CottonEngineering/Cotton/VIPR_PCB/PiHAT_SSR_V4/PiHAT_SSR_V4.brd

## EAGLE design VIPR_PCB/PiHAT_SSR_V4/PiHAT_SSR_V4.brd (2020-04-01)

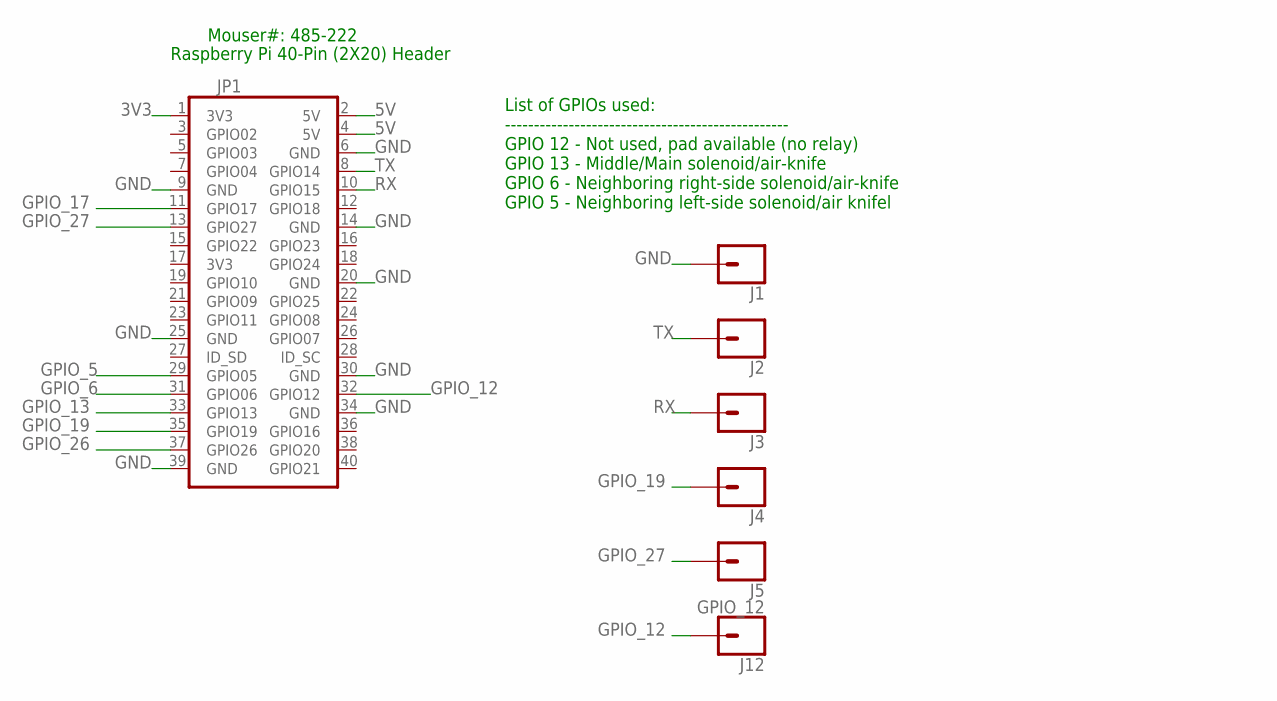
[picture p1: schematic PiHAT_SSR_V4.sch, sheet 1, Raspberry Pi GPIO pin layout schematc]

Parts:
J1, J2, J3, J4, J5: CONN_01; 1X01
J12: GPIO_12; 1X01
JP1: 40W_PI_HAT_TPH; 2X20

Connections:
3V3: JP1.1 (3V3); also elsewhere on the board
5V: JP1.2 (5V), JP1.4 (5V); also elsewhere on the board
GND: J1.1, JP1.6 (GND), JP1.9 (GND), JP1.14 (GND), JP1.20 (GND), JP1.25 (GND), JP1.30 (GND), JP1.34 (GND), JP1.39 (GND); also elsewhere on the board
GPIO_5: JP1.29 (GPIO05); also elsewhere on the board
GPIO_6: JP1.31 (GPIO06); also elsewhere on the board
GPIO_12: J12.1, JP1.32 (GPIO12)
GPIO_13: JP1.33 (GPIO13); also elsewhere on the board
GPIO_17: JP1.11 (GPIO17); also elsewhere on the board
GPIO_19: J4.1, JP1.35 (GPIO19)
GPIO_26: JP1.37 (GPIO26)
GPIO_27: J5.1, JP1.13 (GPIO27)
RX: J3.1, JP1.10 (GPIO15)
TX: J2.1, JP1.8 (GPIO14)

Notes on the sheet:
Raspberry Pi 40-Pin (2X20) Header
List of GPIOs used: ------------------------------------------------- GPIO 12 - Not used, pad available (no relay) GPIO 13 - Middle/Main solenoid/air-knife GPIO 6 - Neighboring right-side solenoid/air-knife GPIO 5 - Neighboring left-side solenoid/air knifel
Mouser#: 485-222

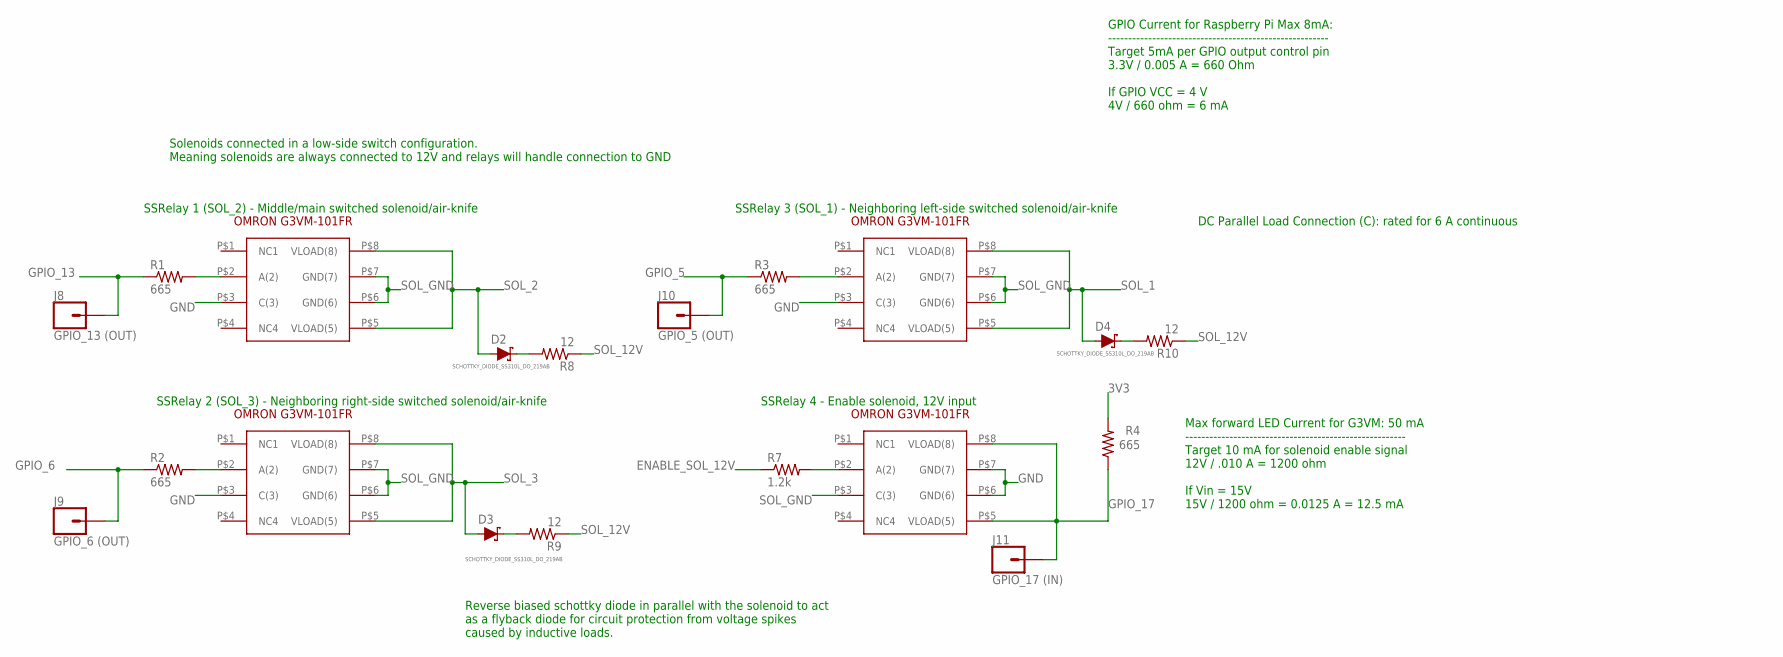
[picture p2: schematic PiHAT_SSR_V4.sch, sheet 2, Solid State Relay layout]

Parts:
D2, D3, D4: SCHOTTKY_DIODE_SS310L_DO_219AB; SCHOTTKY_DIODE_DO219AB
J8: GPIO_13 (OUT); 1X01
J9: GPIO_6 (OUT); 1X01
J10: GPIO_5 (OUT); 1X01
J11: GPIO_17 (IN); 1X01
R1, R2, R3, R4: 665; M0805
R7: 1.2k; M0805
R8, R9, R10: 12; R1210
SSR1, SSR2, SSR3, SSR4: OMRON_G3VM_101FR; OMRON_G3VM-101FR

Connections:
3V3: R4.2; also elsewhere on the board
ENABLE_SOL_12V: R7.1; also elsewhere on the board
GND: SSR1.P$3 (C(3)), SSR2.P$3 (C(3)), SSR3.P$3 (C(3)), SSR4.P$6 (GND(6)), SSR4.P$7 (GND(7)); also elsewhere on the board
GPIO_5: J10.1, R3.1; also elsewhere on the board
GPIO_6: J9.1, R2.1; also elsewhere on the board
GPIO_13: J8.1, R1.1; also elsewhere on the board
GPIO_17: J11.1, R4.1, SSR4.P$5 (VLOAD(5)), SSR4.P$8 (VLOAD(8)); also elsewhere on the board
unnamed: D2.P$2 (C), R8.2
unnamed: R3.2, SSR3.P$2 (A(2))
unnamed: D3.P$2 (C), R9.2
unnamed: R2.2, SSR2.P$2 (A(2))
unnamed: R1.2, SSR1.P$2 (A(2))
unnamed: R7.2, SSR4.P$2 (A(2))
unnamed: D4.P$2 (C), R10.2
SOL_1: D4.P$1 (A), SSR3.P$5 (VLOAD(5)), SSR3.P$8 (VLOAD(8)); also elsewhere on the board
SOL_2: D2.P$1 (A), SSR1.P$5 (VLOAD(5)), SSR1.P$8 (VLOAD(8)); also elsewhere on the board
SOL_3: D3.P$1 (A), SSR2.P$5 (VLOAD(5)), SSR2.P$8 (VLOAD(8)); also elsewhere on the board
SOL_12V: R8.1, R9.1, R10.1; also elsewhere on the board
SOL_GND: SSR1.P$6 (GND(6)), SSR1.P$7 (GND(7)), SSR2.P$6 (GND(6)), SSR2.P$7 (GND(7)), SSR3.P$6 (GND(6)), SSR3.P$7 (GND(7)), SSR4.P$3 (C(3)); also elsewhere on the board

Notes on the sheet:
SSRelay 2 (SOL_3) - Neighboring right-side switched solenoid/air-knife
SSRelay 1 (SOL_2) - Middle/main switched solenoid/air-knife
SSRelay 3 (SOL_1) - Neighboring left-side switched solenoid/air-knife
SSRelay 4 - Enable solenoid, 12V input
GPIO Current for Raspberry Pi Max 8mA: ------------------------------------------------------- Target 5mA per GPIO output control pin 3.3V / 0.005 A = 660 Ohm If GPIO VCC = 4 V 4V / 660 ohm = 6 mA
Max forward LED Current for G3VM: 50 mA ------------------------------------------------------- Target 10 mA for solenoid enable signal 12V / .010 A = 1200 ohm If Vin = 15V 15V / 1200 ohm = 0.0125 A = 12.5 mA
DC Parallel Load Connection (C): rated for 6 A continuous
Solenoids connected in a low-side switch configuration. Meaning solenoids are always connected to 12V and relays will handle connection to GND
Reverse biased schottky diode in parallel with the solenoid to act as a flyback diode for circuit protection from voltage spikes caused by inductive loads.

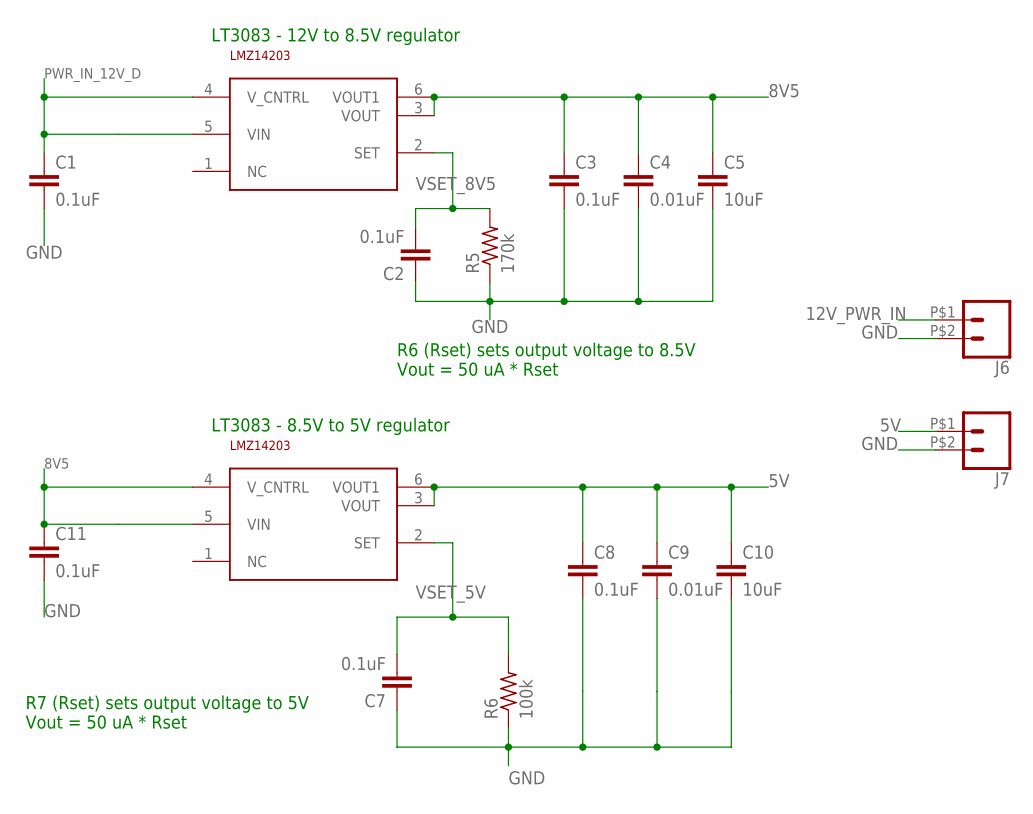
[picture p3: schematic PiHAT_SSR_V4.sch, sheet 3, 12V-5V Voltage regulator]

Parts:
C1, C2, C3, C7, C8, C11: 0.1uF; C0805
C4, C9: 0.01uF; C0805
C5, C10: 10uF; C0805
J6, J7: CONN_02PTH2; 1X02_BIG
R5: 170k; M0805
R6: 100k; M0805
VR1, VR2: SMD-SPECIAL_28PIN_PIC32_11_3_2011_LT3083; SMD-SPECIAL_28PIN_PIC32_11_3_2011_DPAK-5

Connections:
5V: C8.1, C9.1, C10.1, J7.P$1 (1), VR2.3 (VOUT), VR2.6 (VOUT1); also elsewhere on the board
8V5: C3.1, C4.1, C5.1, C11.1, VR1.3 (VOUT), VR1.6 (VOUT1), VR2.4 (V_CNTRL), VR2.5 (VIN)
12V_PWR_IN: J6.P$1 (1); also elsewhere on the board
GND: C1.2, C2.1, C3.2, C4.2, C5.2, C7.1, C8.2, C9.2, C10.2, C11.2, J6.P$2 (2), J7.P$2 (2), R5.1, R6.1; also elsewhere on the board
PWR_IN_12V_D: C1.1, VR1.4 (V_CNTRL), VR1.5 (VIN); also elsewhere on the board
VSET_5V: C7.2, R6.2, VR2.2 (SET)
VSET_8V5: C2.2, R5.2, VR1.2 (SET)

Notes on the sheet:
LT3083 - 12V to 8.5V regulator
R6 (Rset) sets output voltage to 8.5V Vout = 50 uA * Rset
LT3083 - 8.5V to 5V regulator
R7 (Rset) sets output voltage to 5V Vout = 50 uA * Rset

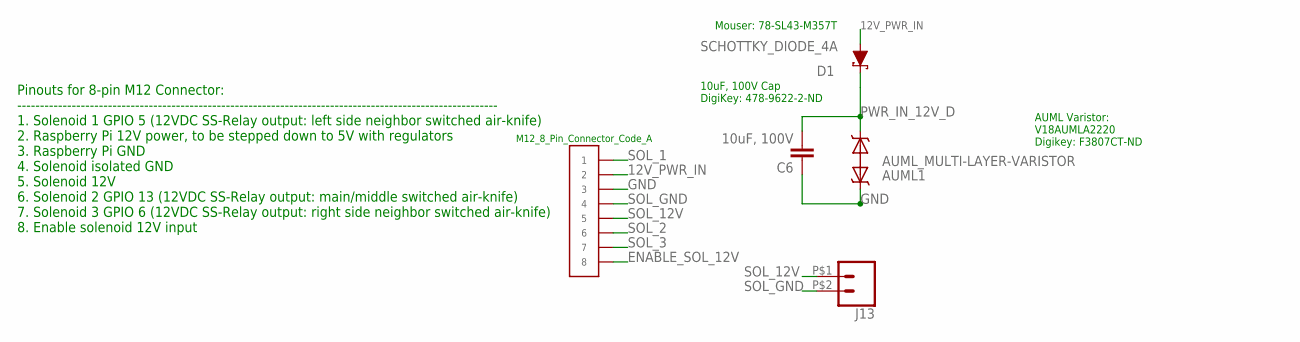
[picture p4: schematic PiHAT_SSR_V4.sch, sheet 4, M12 Connector]

Parts:
AUML1: SMD-SPECIAL_28PIN_PIC32_11_3_2011_MOD5_20_13_AUML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; SMD-SPECIAL_28PIN_PIC32_11_3_2011_MOD5_20_13_SMT_CAP_2220
C6: 10uF, 100V; C2220K
CN1: M12_8PIN_CODE_A
D1: SCHOTTKY_DIODE_4A; SCHOTTKY_DIODE_SMD_DO-214AB
J13: CONN_02PTH2; 1X02_BIG

Connections:
12V_PWR_IN: CN1.P$2, D1.P$2 (A); also elsewhere on the board
ENABLE_SOL_12V: CN1.P$8; also elsewhere on the board
GND: AUML1.1, C6.1, CN1.P$3; also elsewhere on the board
PWR_IN_12V_D: AUML1.2, C6.2, D1.P$1 (C); also elsewhere on the board
SOL_1: CN1.P$1; also elsewhere on the board
SOL_2: CN1.P$6; also elsewhere on the board
SOL_3: CN1.P$7; also elsewhere on the board
SOL_12V: CN1.P$5, J13.P$1 (1); also elsewhere on the board
SOL_GND: CN1.P$4, J13.P$2 (2); also elsewhere on the board

Notes on the sheet:
Pinouts for 8-pin M12 Connector: ---------------------------------------------------------------------------------------------------------- 1. Solenoid 1 GPIO 5 (12VDC SS-Relay output: left side neighbor switched air-knife) 2. Raspberry Pi 12V power, to be stepped down to 5V with regulators 3. Rasp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
AUML_MULTI-LAYER-VARISTOR
10uF, 100V Cap DigiKey: 478-9622-2-ND
AUML Varistor: V18AUMLA2220 Digikey: F3807CT-ND
Mouser: 78-SL43-M357T

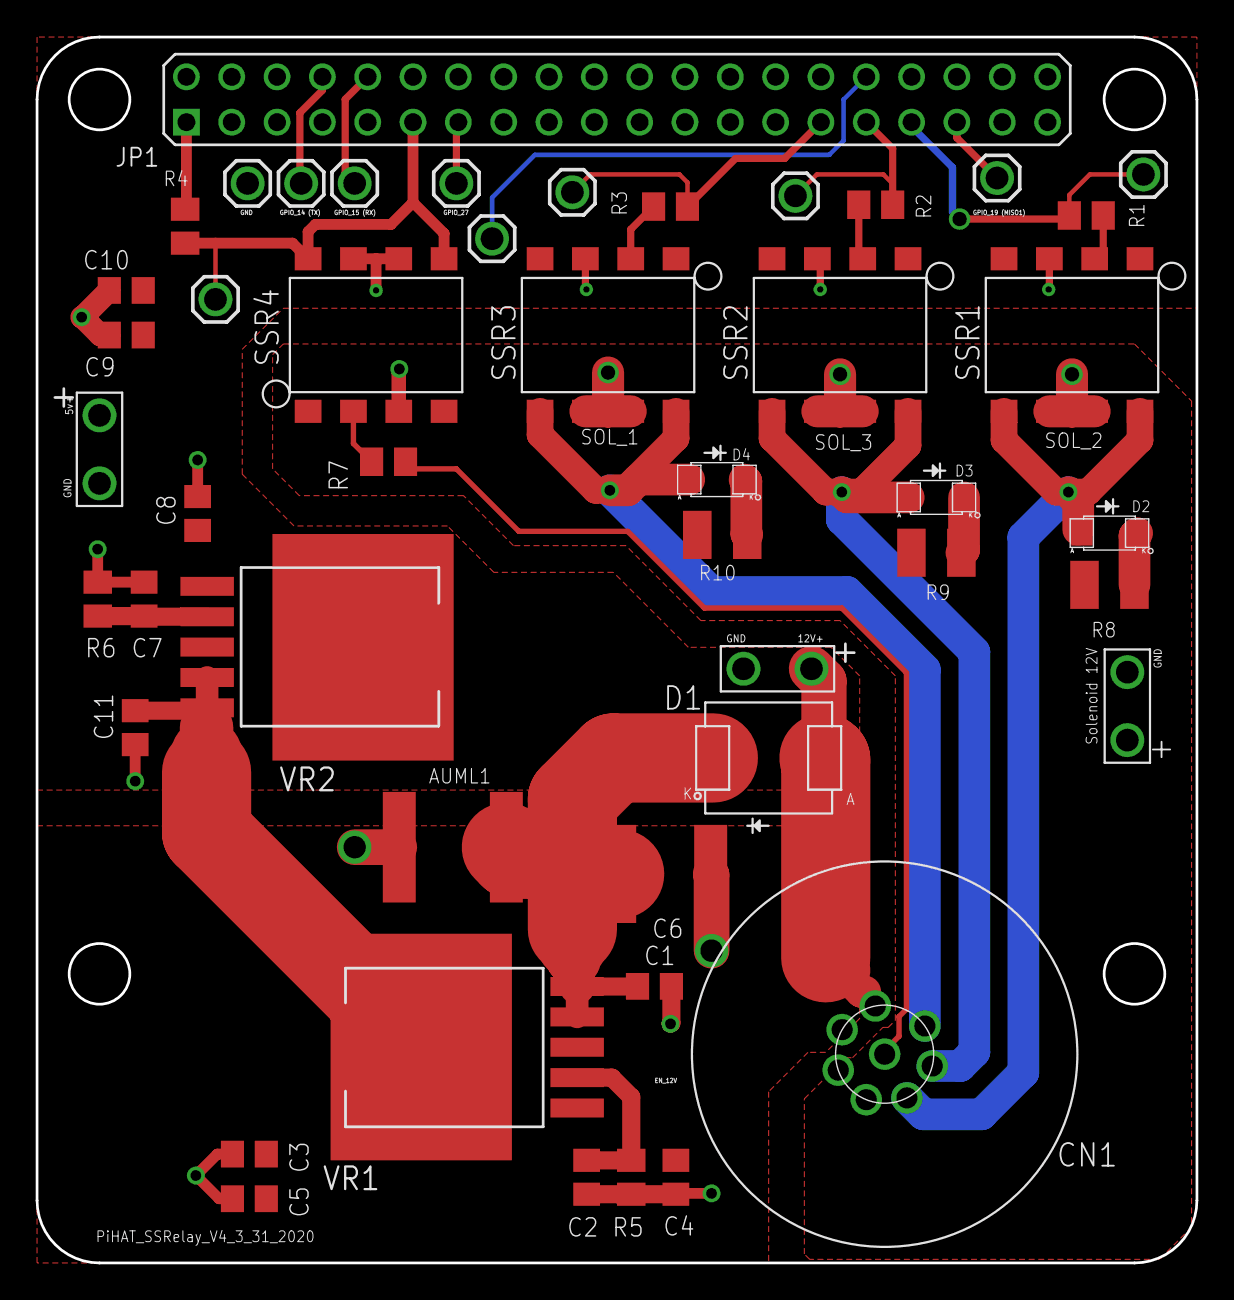
[picture p5: board PiHAT_SSR_V4.brd from above]

Board: 2 copper layers, 65.0 x 68.7 mm, 47 parts (0 on the bottom side), 30 nets.
